excsniper/yasbc/resources/appnotes/iMX6-DDR3-Length-Matching.jpg

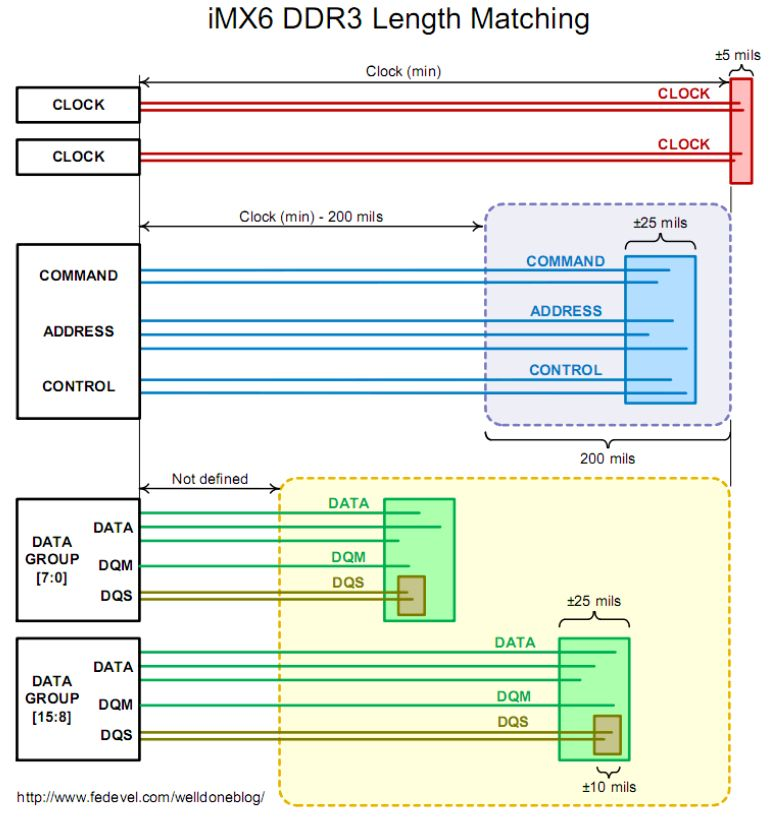
resources/appnotes/iMX6-DDR3-Length-Matching.jpg
