excsniper/yasbc/resources/datasheets/MT3540_Suggested_Layout.PNG

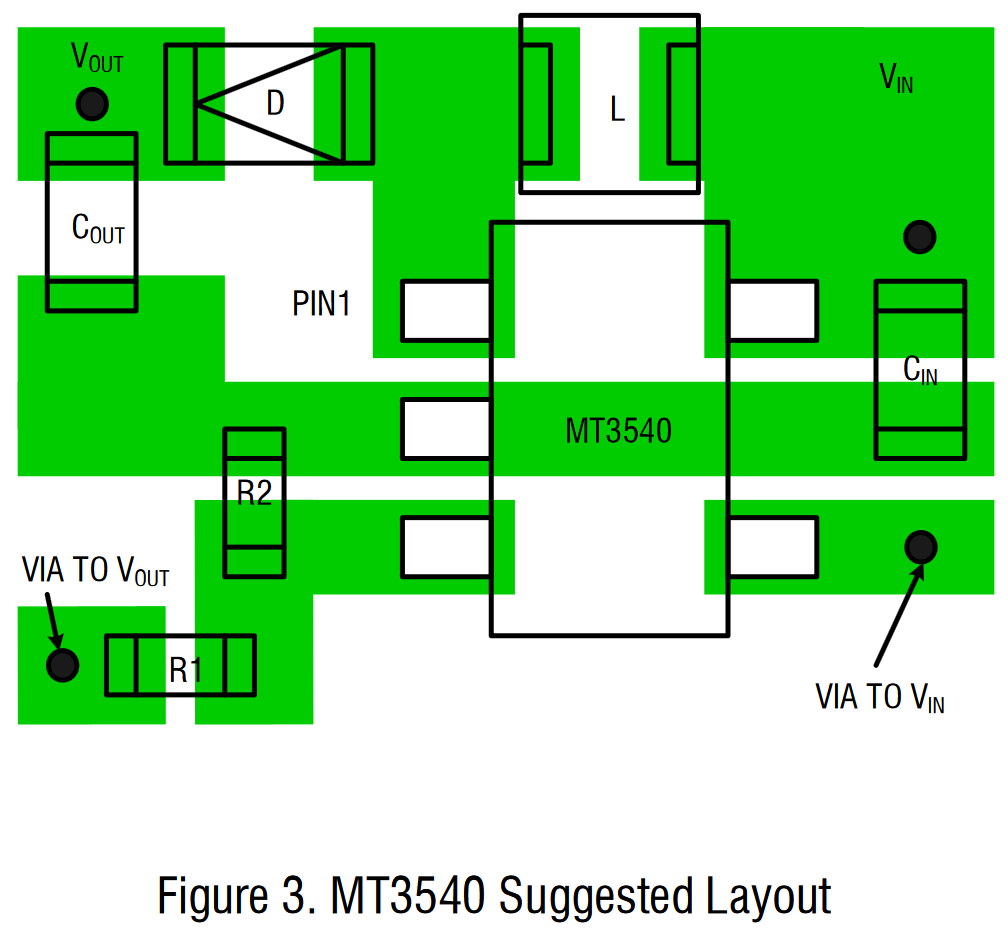
resources/datasheets/MT3540_Suggested_Layout.PNG
