excsniper/yasbc/resources/datasheets/USB_A.jpg

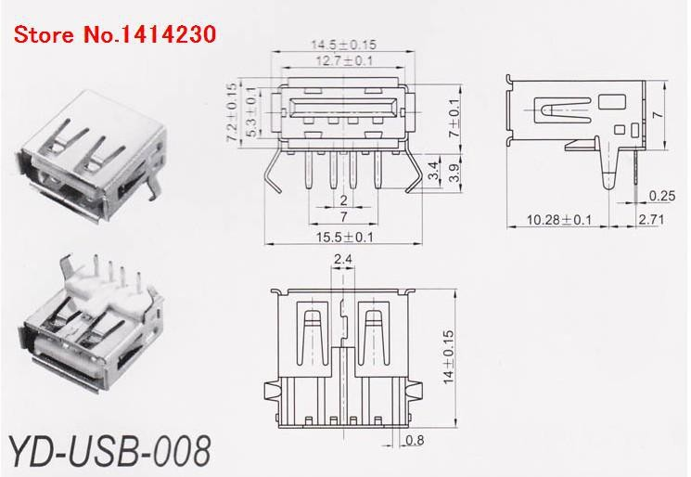
resources/datasheets/USB_A.jpg
