excsniper/yasbc/resources/datasheets/USB_C.png

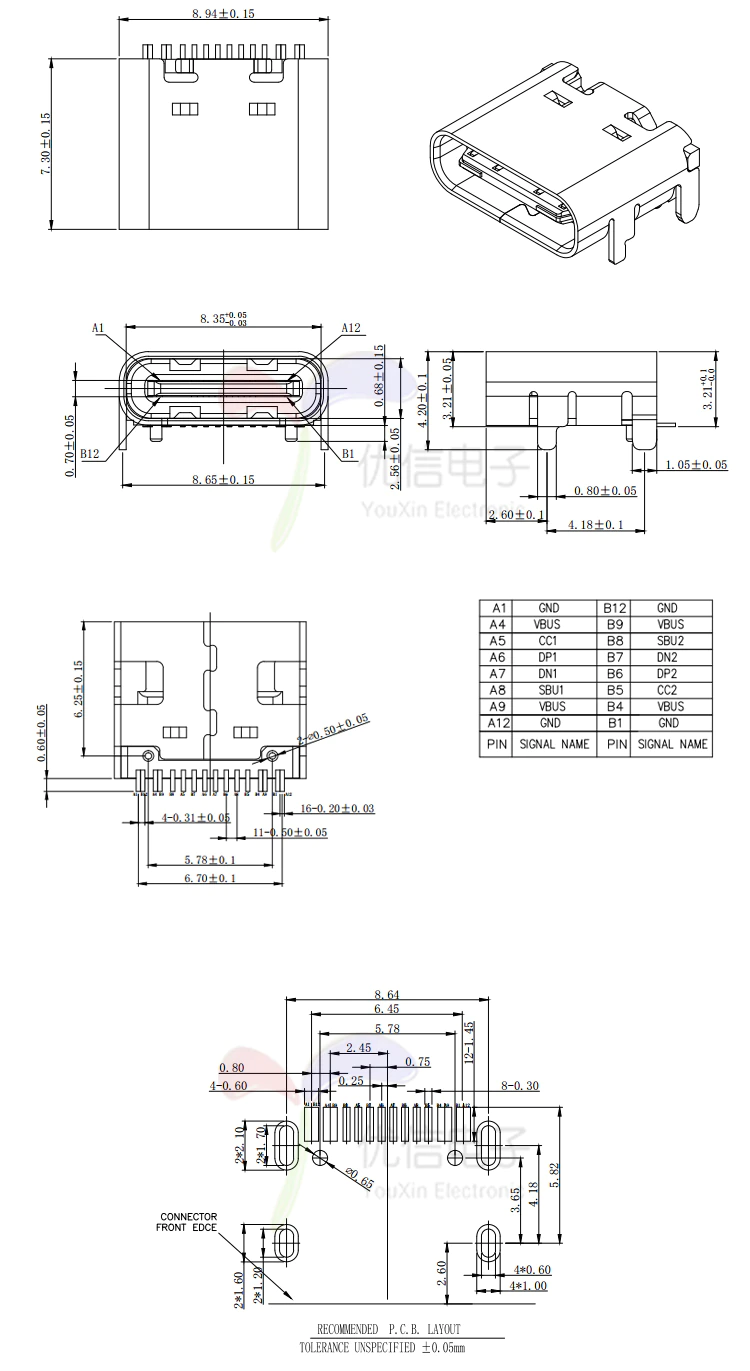
resources/datasheets/USB_C.png
