excsniper/yasbc/pcb/yasbc.kicad_pcb

## KiCad design pcb/yasbc.kicad_pcb (2023-08-11)

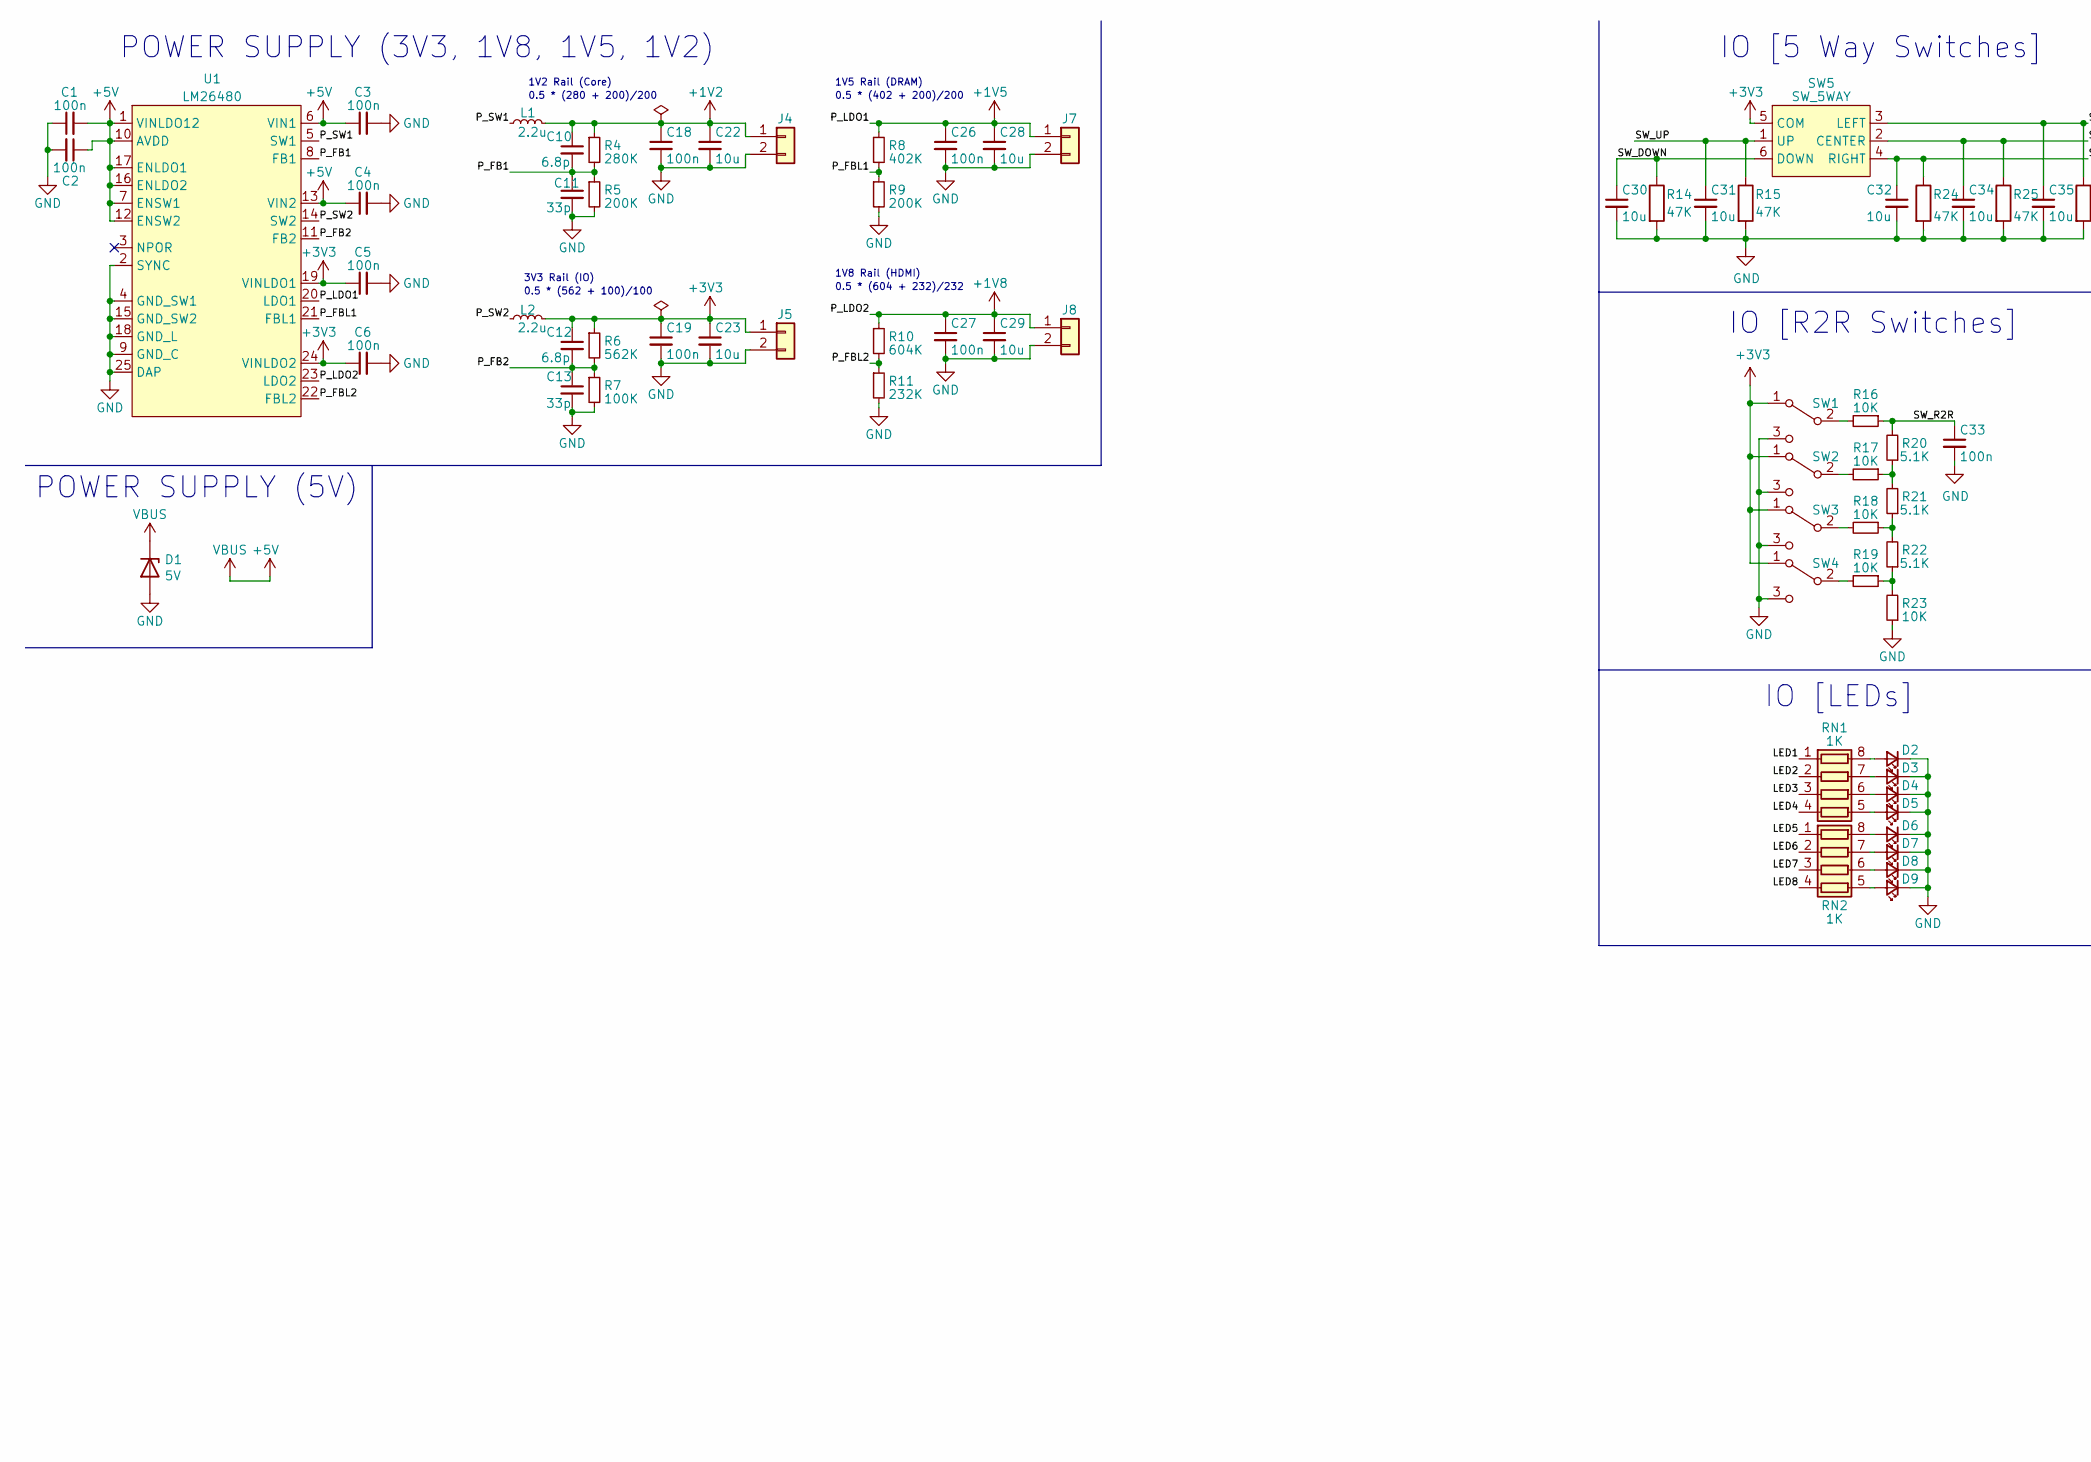
[picture p5: schematic yasbc.kicad_sch, part in row 1, column 1]

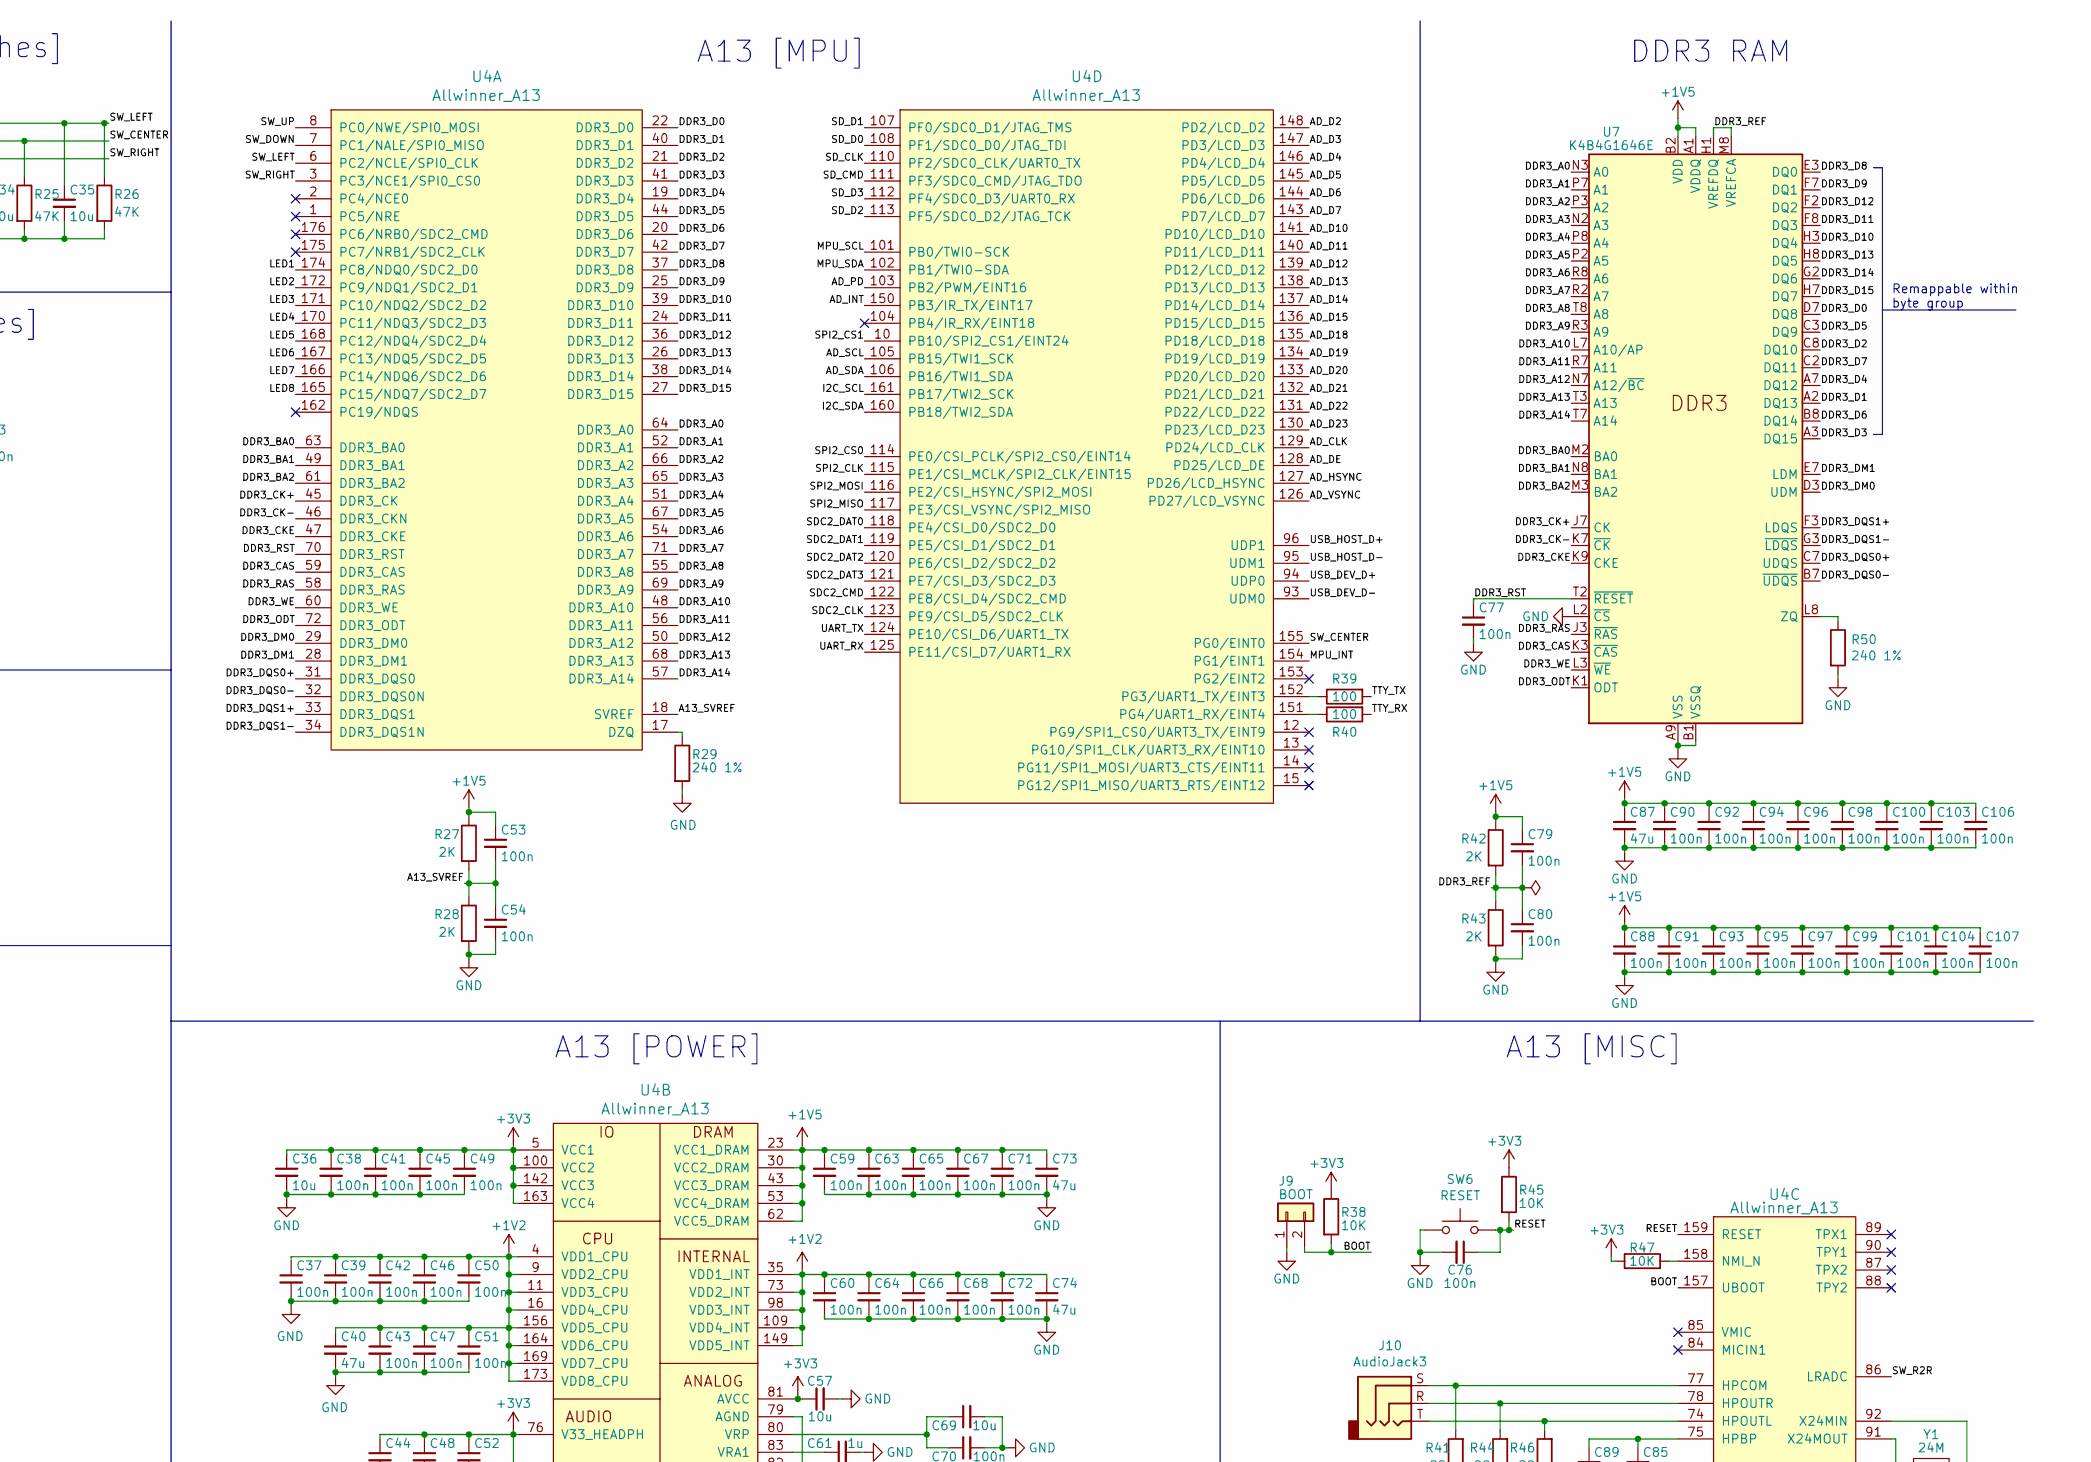
[picture p6: schematic yasbc.kicad_sch, part in row 1, column 2]

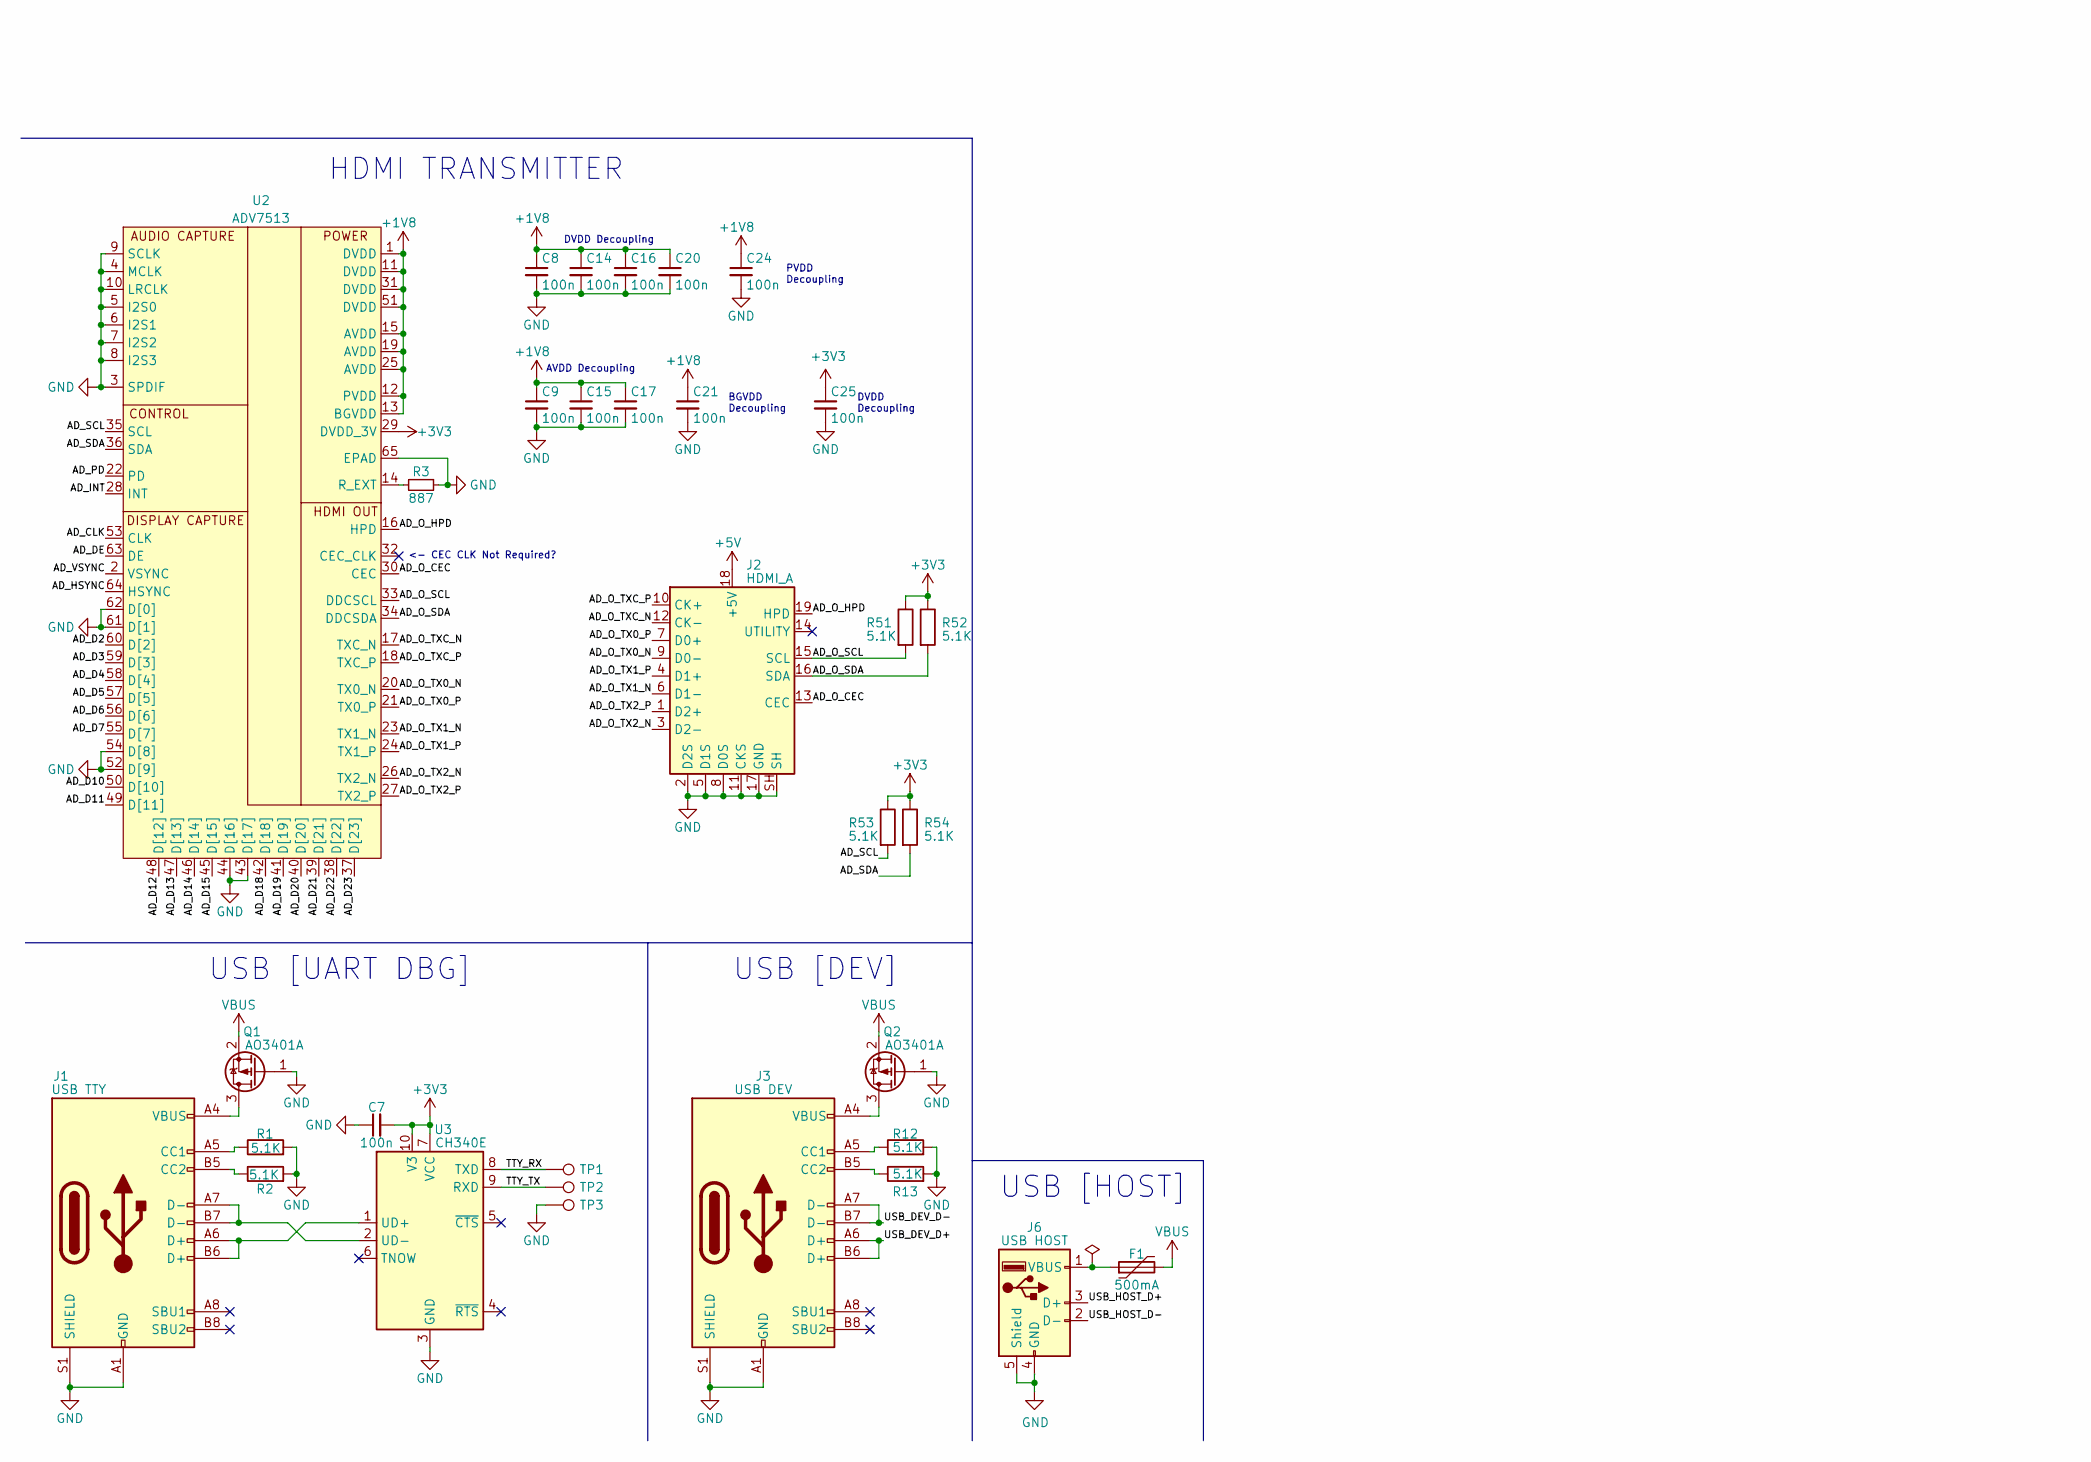
[picture p7: schematic yasbc.kicad_sch, part in row 2, column 1]

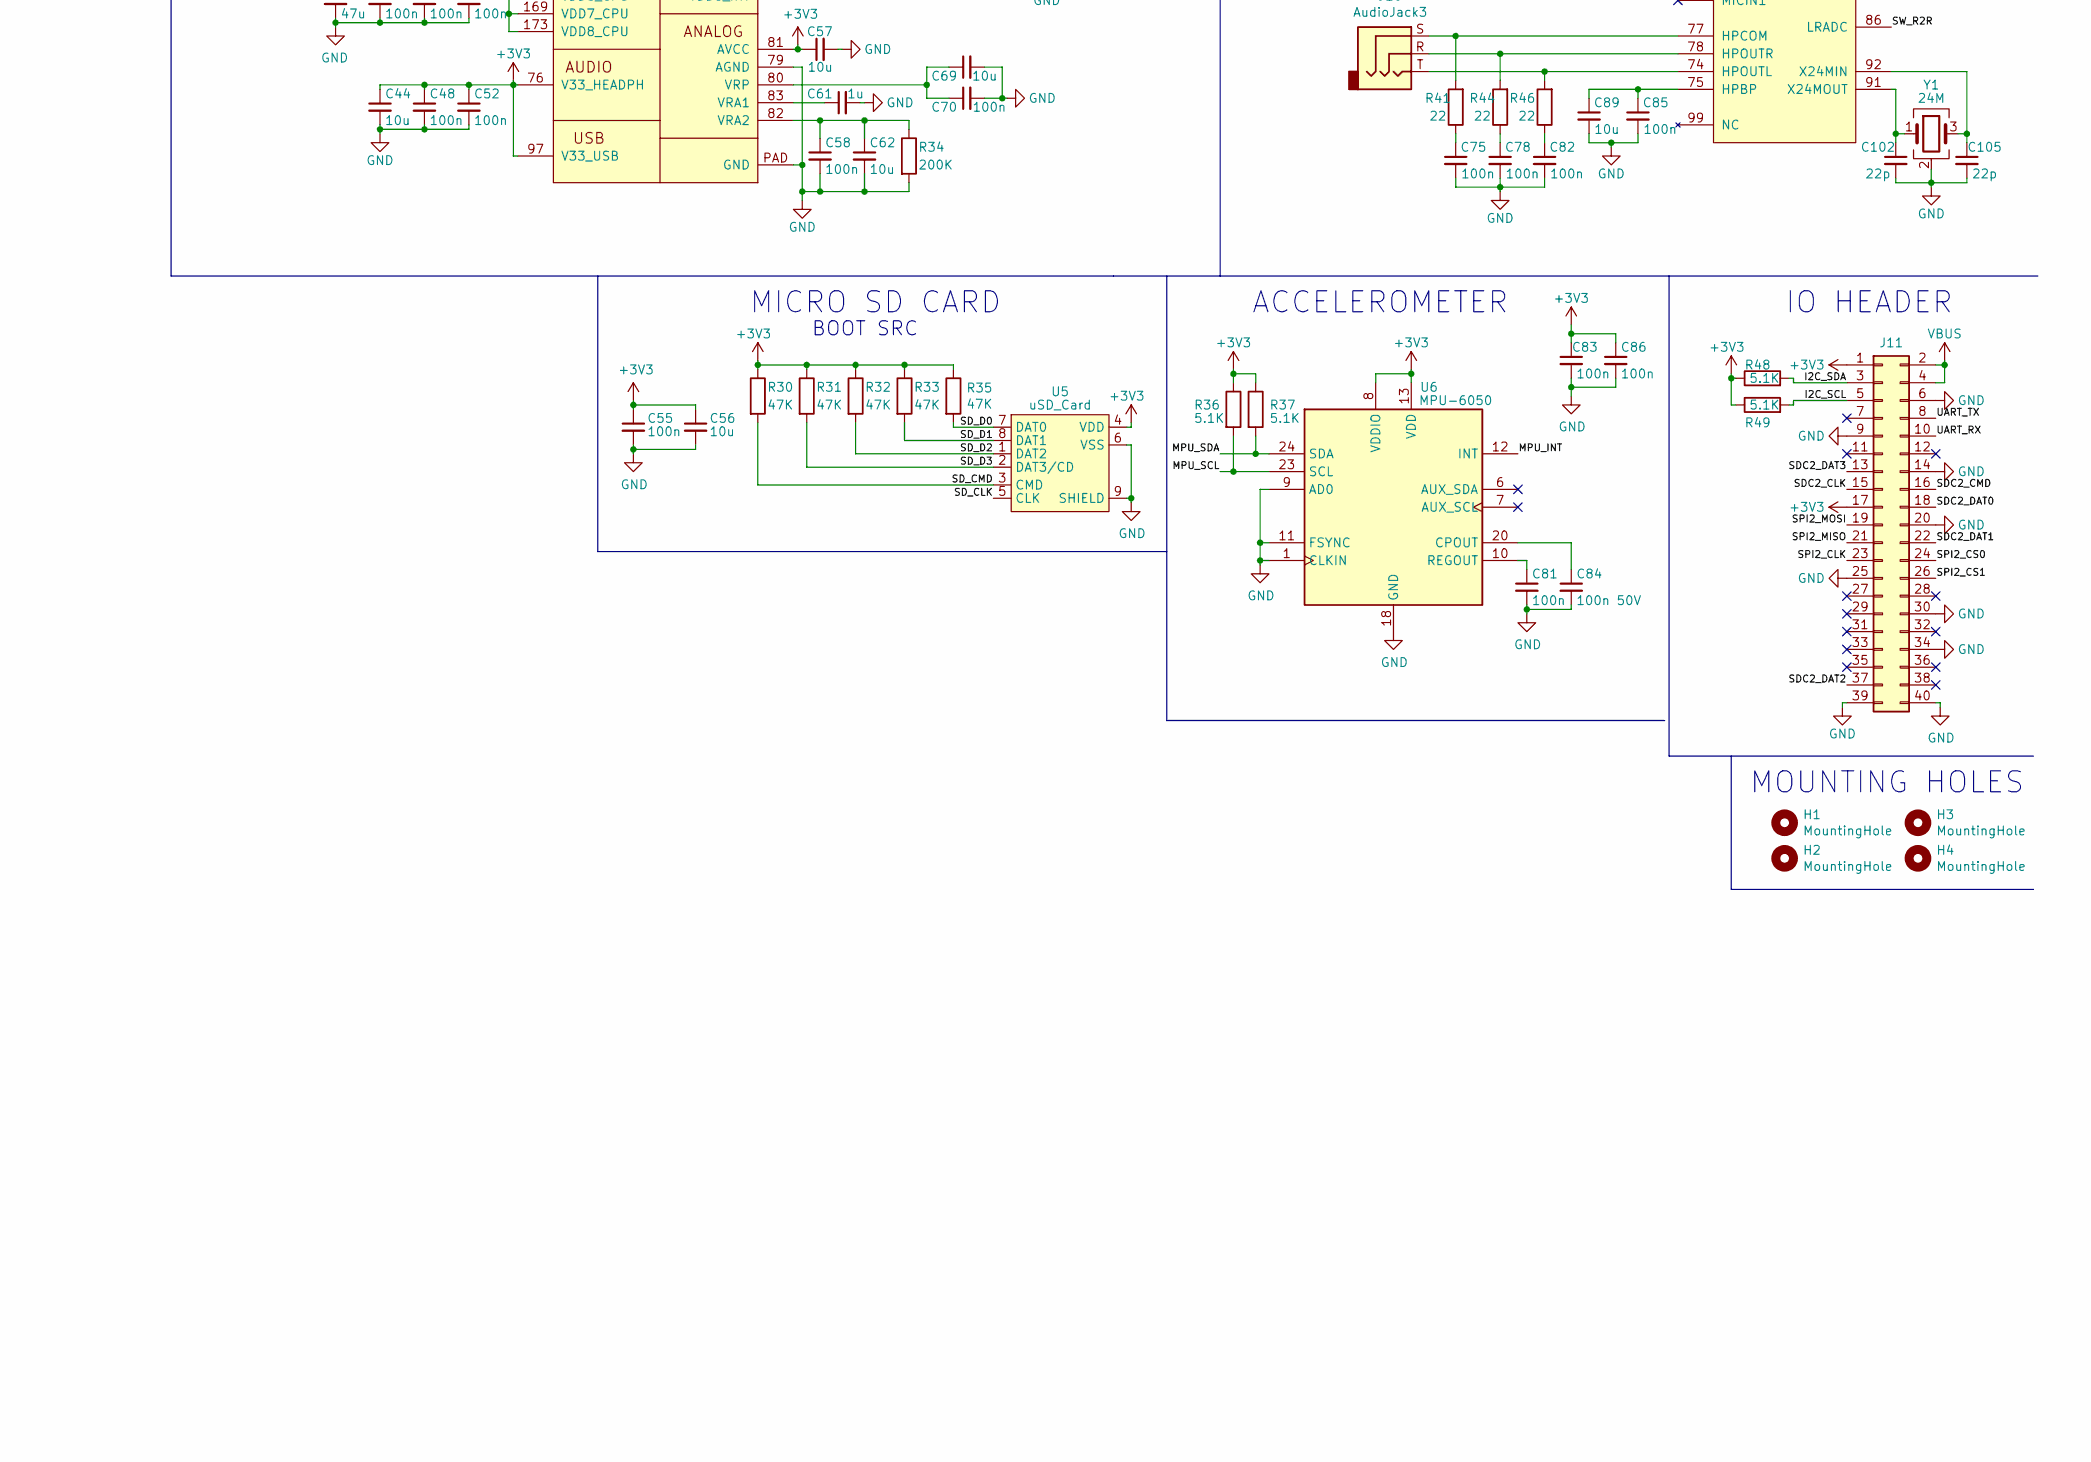
[picture p8: schematic yasbc.kicad_sch, part in row 2, column 2]

Parts:
C1, C2, C3, C4, C5, C6, C7, C8, C9, C14, C15, C16, C17, C18, C19, C20, C21, C24, C25, C26, C27, C33, C37, C38, C39, C41, C42, C43, C45, C46, C47, C48, C49, C50, C51, C52, C53, C54, C55, C58, C59, C60, C63, C64, C65, C66, C67, C68, C70, C71, C72, C75, C76, C77, C78, C79, C80, C81, C82, C83, C85, C86, C88, C90, C91, C92, C93, C94, C95, C96, C97, C98, C99, C100, C101, C103, C104, C106, C107: 100n; C_0402_1005Metric
C10, C12: 6.8p; C_0402_1005Metric
C11, C13: 33p; C_0402_1005Metric
C22, C23, C28, C29, C30, C31, C32, C34, C35, C36, C44, C56, C57, C62, C69, C89: 10u; C_0402_1005Metric
C40, C73, C74, C87: 47u; C_0603_1608Metric
C61: 1u; C_0402_1005Metric
C84: 100n 50V; C_0402_1005Metric
C102, C105: 22p; C_0603_1608Metric
D1: 5V; D_SMB
D2, D3, D4, D5, D6, D7, D8, D9: LED_Small; LED_0603_1608Metric
F1: 500mA; Fuse_0805_2012Metric_Pad1.15x1.40mm_HandSolder
H1, H2, H3, H4: MountingHole; MountingHole_3.2mm_M3
J1: USB TTY; USB_C_Receptacle_HRO_TYPE-C-31-M-12
J2: HDMI_A; HDMI_A_Molex_208658-1001_Horizontal
J3: USB DEV; USB_C_Receptacle_HRO_TYPE-C-31-M-12
J4, J5, J7, J8: 1V5; PinHeader_1x02_P2.54mm_Vertical
J6: USB HOST; USB_A_CONNFLY_DS1095-WNR0
J9: BOOT; PinHeader_1x02_P2.54mm_Vertical
J10: AudioJack3; AudioJack
J11: Conn_02x20_Odd_Even; PinHeader_2x20_P2.54mm_Vertical
L1, L2: 2.2u; Inductor_5.2x5.8x4.5mm
Q1, Q2: AO3401A; SOT-23
R1, R2, R12, R13, R20, R21, R22, R36, R37, R48, R49, R51, R52, R53, R54: 5.1K; R_0603_1608Metric
R3: 887; R_0603_1608Metric
R4: 280K; R_0603_1608Metric
R5, R9, R34: 200K; R_0603_1608Metric
R6: 562K; R_0603_1608Metric
R7: 100K; R_0603_1608Metric
R8: 402K; R_0603_1608Metric
R10: 604K; R_0603_1608Metric
R11: 232K; R_0603_1608Metric
R14, R15, R24, R25, R26, R30, R31, R32, R33, R35: 47K; R_0603_1608Metric
R16, R17, R18, R19, R23, R38, R45, R47: 10K; R_0603_1608Metric
R27, R28, R42, R43: 2K; R_0603_1608Metric
R29, R50: 240 1%; R_0603_1608Metric
R39, R40: 100; R_0603_1608Metric
R41, R44, R46: 22; R_0603_1608Metric
RN1, RN2: 1K; R_Array_Convex_4x0603
SW1, SW2, SW3, SW4: SW_SPDT; SS-12D10
SW5: SW_5WAY; Switches_ALPS-SKRHAAE010
SW6: RESET; HYP-1TS002B-2500-4300-CT
TP1: TX; TestPoint_Pad_D2.0mm
TP2: RX; TestPoint_Pad_D2.0mm
TP3: GND; TestPoint_Pad_D2.0mm
U1: LM26480; WQFN-24-1EP_4x4mm_P0.5mm_EP2.6x2.6mm
U2: ADV7513; LQFP-64-1EP_10x10mm_P0.5mm_EP5x5mm
U3: CH340E; MSOP-10_3x3mm_P0.5mm
U4: Allwinner_A13; LQFP-176_20x20mm_P0.4mm_PAD
U5: uSD_Card; microSD
U6: MPU-6050; InvenSense_QFN-24_4x4mm_P0.5mm
U7: K4B4G1646E; BGA-96_9.0x13.0mm_Layout2x3x16_P0.8mm
Y1: 24M; Crystal_SMD_2016-4Pin_2.0x1.6mm

Connections:
+1V2: C10.1, C18.1, C22.1, C37.1, C39.1, C40.1, C42.1, C43.1, C46.1, C47.1, C50.1, C51.1, C60.1, C64.1, C66.1, C68.1, C72.1, C74.1, J4.1, L1.2, R4.1, U4.4 (VDD1_CPU), U4.9 (VDD2_CPU), U4.11 (VDD3_CPU), U4.16 (VDD4_CPU), U4.35 (VDD1_INT), U4.73 (VDD2_INT), U4.98 (VDD3_INT), U4.109 (VDD4_INT), U4.149 (VDD5_INT), U4.156 (VDD5_CPU), U4.164 (VDD6_CPU), U4.169 (VDD7_CPU), U4.173 (VDD8_CPU)
+1V5: C26.1, C28.1, C53.1, C59.1, C63.1, C65.1, C67.1, C71.1, C73.1, C79.1, C87.1, C88.1, C90.1, C91.1, C92.1, C93.1, C94.1, C95.1, C96.1, C97.1, C98.1, C99.1, C100.1, C101.1, C103.1, C104.1, C106.1, C107.1, J7.1, R8.1, R27.1, R42.1, U1.20 (LDO1), U4.23 (VCC1_DRAM), U4.30 (VCC2_DRAM), U4.43 (VCC3_DRAM), U4.53 (VCC4_DRAM), U4.62 (VCC5_DRAM), U7.A1 (VDDQ), U7.A8 (VDDQ), U7.B2 (VDD), U7.C1 (VDDQ), U7.C9 (VDDQ), U7.D2 (VDDQ), U7.D9 (VDD), U7.E9 (VDDQ), U7.F1 (VDDQ), U7.G7 (VDD), U7.H2 (VDDQ), U7.H9 (VDDQ), U7.K2 (VDD), U7.K8 (VDD), U7.N1 (VDD), U7.N9 (VDD), U7.R1 (VDD), U7.R9 (VDD)
+1V8: C8.1, C9.1, C14.1, C15.1, C16.1, C17.1, C20.1, C21.1, C24.1, C27.1, C29.1, J8.1, R10.1, U1.23 (LDO2), U2.1 (DVDD), U2.11 (DVDD), U2.12 (PVDD), U2.13 (BGVDD), U2.15 (AVDD), U2.19 (AVDD), U2.25 (AVDD), U2.31 (DVDD), U2.51 (DVDD)
+3V3: C5.1, C6.1, C7.2, C12.1, C19.1, C23.1, C25.1, C36.1, C38.1, C41.1, C44.1, C45.1, C48.1, C49.1, C52.1, C55.1, C56.1, C57.1, C83.1, C86.1, J5.1, J11.1, J11.17, L2.2, R6.1, R30.1, R31.1, R32.1, R33.1, R35.1, R36.1, R37.1, R38.1, R45.1, R47.1, R48.1, R49.1, R51.1, R52.1, R53.1, R54.1, SW1.1 (A), SW2.1 (A), SW3.1 (A), SW4.1 (A), SW5.5 (COM), U1.19 (VINLDO1), U1.24 (VINLDO2), U2.29 (DVDD_3V), U3.7 (VCC), U3.10 (V3), U4.5 (VCC1), U4.76 (V33_HEADPH), U4.81 (AVCC), U4.97 (V33_USB), U4.100 (VCC2), U4.142 (VCC3), U4.163 (VCC4), U5.4 (VDD), U6.8 (VDDIO), U6.13 (VDD)
+5V: C1.2, C2.1, C3.1, C4.1, D1.1 (K), F1.2, J2.18 (+5V), J11.2, J11.4, Q1.2 (S), Q2.2 (S), U1.1 (VINLDO12), U1.6 (VIN1), U1.7 (ENSW1), U1.10 (AVDD), U1.12 (ENSW2), U1.13 (VIN2), U1.16 (ENLDO2), U1.17 (ENLDO1)
/A13_SVREF: C53.2, C54.1, R27.2, R28.1, U4.18 (SVREF)
/AD_CLK: U2.53 (CLK), U4.129 (PD24/LCD_CLK)
/AD_D2: U2.60 (D[2]), U4.148 (PD2/LCD_D2)
/AD_D3: U2.59 (D[3]), U4.147 (PD3/LCD_D3)
/AD_D4: U2.58 (D[4]), U4.146 (PD4/LCD_D4)
/AD_D5: U2.57 (D[5]), U4.145 (PD5/LCD_D5)
/AD_D6: U2.56 (D[6]), U4.144 (PD6/LCD_D6)
/AD_D7: U2.55 (D[7]), U4.143 (PD7/LCD_D7)
/AD_D10: U2.50 (D[10]), U4.141 (PD10/LCD_D10)
/AD_D11: U2.49 (D[11]), U4.140 (PD11/LCD_D11)
/AD_D12: U2.48 (D[12]), U4.139 (PD12/LCD_D12)
/AD_D13: U2.47 (D[13]), U4.138 (PD13/LCD_D13)
/AD_D14: U2.46 (D[14]), U4.137 (PD14/LCD_D14)
/AD_D15: U2.45 (D[15]), U4.136 (PD15/LCD_D15)
/AD_D18: U2.42 (D[18]), U4.135 (PD18/LCD_D18)
/AD_D19: U2.41 (D[19]), U4.134 (PD19/LCD_D19)
/AD_D20: U2.40 (D[20]), U4.133 (PD20/LCD_D20)
/AD_D21: U2.39 (D[21]), U4.132 (PD21/LCD_D21)
/AD_D22: U2.38 (D[22]), U4.131 (PD22/LCD_D22)
/AD_D23: U2.37 (D[23]), U4.130 (PD23/LCD_D23)
/AD_DE: U2.63 (DE), U4.128 (PD25/LCD_DE)
/AD_HSYNC: U2.64 (HSYNC), U4.127 (PD26/LCD_HSYNC)
/AD_INT: U2.28 (INT), U4.150 (PB3/IR_TX/EINT17)
/AD_O_CEC: J2.13 (CEC), U2.30 (CEC)
/AD_O_HPD: J2.19 (HPD), U2.16 (HPD)
/AD_O_SCL: J2.15 (SCL), R51.2, U2.33 (DDCSCL)
/AD_O_SDA: J2.16 (SDA), R52.2, U2.34 (DDCSDA)
/AD_O_TX0_N: J2.9 (D0-), U2.20 (TX0_N)
/AD_O_TX0_P: J2.7 (D0+), U2.21 (TX0_P)
/AD_O_TX1_N: J2.6 (D1-), U2.23 (TX1_N)
/AD_O_TX1_P: J2.4 (D1+), U2.24 (TX1_P)
/AD_O_TX2_N: J2.3 (D2-), U2.26 (TX2_N)
/AD_O_TX2_P: J2.1 (D2+), U2.27 (TX2_P)
/AD_O_TXC_N: J2.12 (CK-), U2.17 (TXC_N)
/AD_O_TXC_P: J2.10 (CK+), U2.18 (TXC_P)
/AD_PD: U2.22 (PD), U4.103 (PB2/PWM/EINT16)
/AD_SCL: R53.2, U2.35 (SCL), U4.105 (PB15/TWI1_SCK)
/AD_SDA: R54.2, U2.36 (SDA), U4.106 (PB16/TWI1_SDA)
/AD_VSYNC: U2.2 (VSYNC), U4.126 (PD27/LCD_VSYNC)
/BOOT: J9.2, R38.2, U4.157 (UBOOT)
/DDR3_A0: U4.64 (DDR3_A0), U7.N3 (A0)
/DDR3_A1: U4.52 (DDR3_A1), U7.P7 (A1)
/DDR3_A2: U4.66 (DDR3_A2), U7.P3 (A2)
/DDR3_A3: U4.65 (DDR3_A3), U7.N2 (A3)
/DDR3_A4: U4.51 (DDR3_A4), U7.P8 (A4)
/DDR3_A5: U4.67 (DDR3_A5), U7.P2 (A5)
/DDR3_A6: U4.54 (DDR3_A6), U7.R8 (A6)
/DDR3_A7: U4.71 (DDR3_A7), U7.R2 (A7)
/DDR3_A8: U4.55 (DDR3_A8), U7.T8 (A8)
/DDR3_A9: U4.69 (DDR3_A9), U7.R3 (A9)
/DDR3_A10: U4.48 (DDR3_A10), U7.L7 (A10/AP)
/DDR3_A11: U4.56 (DDR3_A11), U7.R7 (A11)
/DDR3_A12: U4.50 (DDR3_A12), U7.N7 (A12/~BC)
/DDR3_A13: U4.68 (DDR3_A13), U7.T3 (A13)
/DDR3_A14: U4.57 (DDR3_A14), U7.T7 (A14)
/DDR3_BA0: U4.63 (DDR3_BA0), U7.M2 (BA0)
/DDR3_BA1: U4.49 (DDR3_BA1), U7.N8 (BA1)
/DDR3_BA2: U4.61 (DDR3_BA2), U7.M3 (BA2)
/DDR3_CAS: U4.59 (DDR3_CAS), U7.K3 (~CAS)
/DDR3_CK+: U4.45 (DDR3_CK), U7.J7 (CK)
/DDR3_CK-: U4.46 (DDR3_CKN), U7.K7 (~CK)
/DDR3_CKE: U4.47 (DDR3_CKE), U7.K9 (CKE)
/DDR3_D0: U4.22 (DDR3_D0), U7.D7 (DQ8)
/DDR3_D1: U4.40 (DDR3_D1), U7.A2 (DQ13)
/DDR3_D2: U4.21 (DDR3_D2), U7.C8 (DQ10)
/DDR3_D3: U4.41 (DDR3_D3), U7.A3 (DQ15)
/DDR3_D4: U4.19 (DDR3_D4), U7.A7 (DQ12)
/DDR3_D5: U4.44 (DDR3_D5), U7.C3 (DQ9)
/DDR3_D6: U4.20 (DDR3_D6), U7.B8 (DQ14)
/DDR3_D7: U4.42 (DDR3_D7), U7.C2 (DQ11)
/DDR3_D8: U4.37 (DDR3_D8), U7.E3 (DQ0)
/DDR3_D9: U4.25 (DDR3_D9), U7.F7 (DQ1)
/DDR3_D10: U4.39 (DDR3_D10), U7.H3 (DQ4)
/DDR3_D11: U4.24 (DDR3_D11), U7.F8 (DQ3)
/DDR3_D12: U4.36 (DDR3_D12), U7.F2 (DQ2)
/DDR3_D13: U4.26 (DDR3_D13), U7.H8 (DQ5)
/DDR3_D14: U4.38 (DDR3_D14), U7.G2 (DQ6)
/DDR3_D15: U4.27 (DDR3_D15), U7.H7 (DQ7)
/DDR3_DM0: U4.29 (DDR3_DM0), U7.D3 (UDM)
/DDR3_DM1: U4.28 (DDR3_DM1), U7.E7 (LDM)
/DDR3_DQS0+: U4.31 (DDR3_DQS0), U7.C7 (UDQS)
/DDR3_DQS0-: U4.32 (DDR3_DQS0N), U7.B7 (~UDQS)
/DDR3_DQS1+: U4.33 (DDR3_DQS1), U7.F3 (LDQS)
/DDR3_DQS1-: U4.34 (DDR3_DQS1N), U7.G3 (~LDQS)
/DDR3_ODT: U4.72 (DDR3_ODT), U7.K1 (ODT)
/DDR3_RAS: U4.58 (DDR3_RAS), U7.J3 (~RAS)
/DDR3_REF: C79.2, C80.1, R42.2, R43.1, U7.H1 (VREFDQ), U7.M8 (VREFCA)
/DDR3_RST: C77.1, U4.70 (DDR3_RST), U7.T2 (~RESET)
/DDR3_WE: U4.60 (DDR3_WE), U7.L3 (~WE)
/I2C_SCL: J11.5, R49.2, U4.161 (PB17/TWI2_SCK)
/I2C_SDA: J11.3, R48.2, U4.160 (PB18/TWI2_SDA)
/LED1: RN1.1 (R1.1), U4.174 (PC8/NDQ0/SDC2_D0)
/LED2: RN1.2 (R2.1), U4.172 (PC9/NDQ1/SDC2_D1)
/LED3: RN1.3 (R3.1), U4.171 (PC10/NDQ2/SDC2_D2)
/LED4: RN1.4 (R4.1), U4.170 (PC11/NDQ3/SDC2_D3)
/LED5: RN2.1 (R1.1), U4.168 (PC12/NDQ4/SDC2_D4)
/LED6: RN2.2 (R2.1), U4.167 (PC13/NDQ5/SDC2_D5)
/LED7: RN2.3 (R3.1), U4.166 (PC14/NDQ6/SDC2_D6)
/LED8: RN2.4 (R4.1), U4.165 (PC15/NDQ7/SDC2_D7)
/MPU_INT: U4.154 (PG1/EINT1), U6.12 (INT)
/MPU_SCL: R36.2, U4.101 (PB0/TWI0-SCK), U6.23 (SCL)
/MPU_SDA: R37.2, U4.102 (PB1/TWI0-SDA), U6.24 (SDA)
/P_FB1: C10.2, C11.1, R4.2, R5.1, U1.8 (FB1)
/P_FB2: C12.2, C13.1, R6.2, R7.1, U1.11 (FB2)
/P_FBL1: R8.2, R9.1, U1.21 (FBL1)
/P_FBL2: R10.2, R11.1, U1.22 (FBL2)
/P_SW1: L1.1, U1.5 (SW1)
/P_SW2: L2.1, U1.14 (SW2)
/RESET: C76.1, R45.2, SW6.2, U4.159 (RESET)
/SDC2_CLK: J11.15, U4.123 (PE9/CSI_D5/SDC2_CLK)
/SDC2_CMD: J11.16, U4.122 (PE8/CSI_D4/SDC2_CMD)
/SDC2_DAT0: J11.18, U4.118 (PE4/CSI_D0/SDC2_D0)
/SDC2_DAT1: J11.22, U4.119 (PE5/CSI_D1/SDC2_D1)
/SDC2_DAT2: J11.37, U4.120 (PE6/CSI_D2/SDC2_D2)
/SDC2_DAT3: J11.13, U4.121 (PE7/CSI_D3/SDC2_D3)
/SD_CLK: U4.110 (PF2/SDC0_CLK/UART0_TX), U5.5 (CLK)
/SD_CMD: R30.2, U4.111 (PF3/SDC0_CMD/JTAG_TDO), U5.3 (CMD)
/SD_D0: R35.2, U4.108 (PF1/SDC0_D0/JTAG_TDI), U5.7 (DAT0)
/SD_D1: R33.2, U4.107 (PF0/SDC0_D1/JTAG_TMS), U5.8 (DAT1)
/SD_D2: R32.2, U4.113 (PF5/SDC0_D2/JTAG_TCK), U5.1 (DAT2)
/SD_D3: R31.2, U4.112 (PF4/SDC0_D3/UART0_RX), U5.2 (DAT3/CD)
/SPI2_CLK: J11.23, U4.115 (PE1/CSI_MCLK/SPI2_CLK/EINT15)
/SPI2_CS0: J11.24, U4.114 (PE0/CSI_PCLK/SPI2_CS0/EINT14)
/SPI2_CS1: J11.26, U4.10 (PB10/SPI2_CS1/EINT24)
/SPI2_MISO: J11.21, U4.117 (PE3/CSI_VSYNC/SPI2_MISO)
/SPI2_MOSI: J11.19, U4.116 (PE2/CSI_HSYNC/SPI2_MOSI)
/SW_CENTER: C34.1, R25.1, SW5.2 (CENTER), U4.155 (PG0/EINT0)
/SW_DOWN: C30.1, R14.1, SW5.6 (DOWN), U4.7 (PC1/NALE/SPI0_MISO)
/SW_LEFT: C35.1, R26.1, SW5.3 (LEFT), U4.6 (PC2/NCLE/SPI0_CLK)
/SW_R2R: C33.1, R16.1, R20.2, U4.86 (LRADC)
/SW_RIGHT: C32.1, R24.1, SW5.4 (RIGHT), U4.3 (PC3/NCE1/SPI0_CS0)
/SW_UP: C31.1, R15.1, SW5.1 (UP), U4.8 (PC0/NWE/SPI0_MOSI)
/TTY_RX: R40.2, TP1.1, U3.8 (TXD)
/TTY_TX: R39.2, TP2.1, U3.9 (RXD)
/UART_RX: J11.10, U4.125 (PE11/CSI_D7/UART1_RX)
/UART_TX: J11.8, U4.124 (PE10/CSI_D6/UART1_TX)
/USB_DEV_D+: J3.A6 (D+), J3.B6 (D+), U4.94 (UDP0)
/USB_DEV_D-: J3.A7 (D-), J3.B7 (D-), U4.93 (UDM0)
/USB_HOST_D+: J6.3 (D+), U4.96 (UDP1)
/USB_HOST_D-: J6.2 (D-), U4.95 (UDM1)
GND: C1.1, C2.2, C3.2, C4.2, C5.2, C6.2, C7.1, C8.2, C9.2, C11.2, C13.2, C14.2, C15.2, C16.2, C17.2, C18.2, C19.2, C20.2, C21.2, C22.2, C23.2, C24.2, C25.2, C26.2, C27.2, C28.2, C29.2, C30.2, C31.2, C32.2, C33.2, C34.2, C35.2, C36.2, C37.2, C38.2, C39.2, C40.2, C41.2, C42.2, C43.2, C44.2, C45.2, C46.2, C47.2, C48.2, C49.2, C50.2, C51.2, C52.2, C54.2, C55.2, C56.2, C57.2, C58.2, C59.2, C60.2, C61.2, C62.2, C63.2, C64.2, C65.2, C66.2, C67.2, C68.2, C69.2, C70.2, C71.2, C72.2, C73.2, C74.2, C75.2, C76.2, C77.2, C78.2, C80.2, C81.2, C82.2, C83.2, C84.2, C85.2, C86.2, C87.2, C88.2, C89.2, C90.2, C91.2, C92.2, C93.2, C94.2, C95.2, C96.2, C97.2, C98.2, C99.2, C100.2, C101.2, C102.2, C103.2, C104.2, C105.2, C106.2, C107.2, D1.2 (A), D2.1 (K), D3.1 (K), D4.1 (K), D5.1 (K), D6.1 (K), D7.1 (K), D8.1 (K), D9.1 (K), J1.A1 (GND), J1.A12 (GND), J1.B1 (GND), J1.B12 (GND), J1.S1 (SHIELD), J2.2 (D2S), J2.5 (D1S), J2.8 (D0S), J2.11 (CKS), J2.17 (GND), J2.SH, J3.A1 (GND), J3.A12 (GND), J3.B1 (GND), J3.B12 (GND), J3.S1 (SHIELD), J4.2, J5.2, J6.4 (GND), J6.5 (Shield), J7.2, J8.2, J9.1, J11.6, J11.9, J11.14, J11.20, J11.25, J11.30, J11.34, J11.39, J11.40, Q1.1 (G), Q2.1 (G), R1.2, R2.2, R3.1, R5.2, R7.2, R9.2, R11.2, R12.2, R13.2, R14.2, R15.2, R23.1, R24.2, R25.2, R26.2, R28.2, R29.2, R34.2, R43.2, R50.2, SW1.3 (C), SW2.3 (C), SW3.3 (C), SW4.3 (C), SW6.1, TP3.1, U1.2 (SYNC), U1.4 (GND_SW1), U1.9 (GND_C), U1.15 (GND_SW2), U1.18 (GND_L), U1.25 (DAP), U2.3 (SPDIF), U2.4 (MCLK), U2.5 (I2S0), U2.6 (I2S1), U2.7 (I2S2), U2.8 (I2S3), U2.9 (SCLK), U2.10 (LRCLK), U2.43 (D[17]), U2.44 (D[16]), U2.52 (D[9]), U2.54 (D[8]), U2.61 (D[1]), U2.62 (D[0]), U2.65 (EPAD), U3.3 (GND), U4.79 (AGND), U4.PAD (GND), U5.6 (VSS), U5.9 (SHIELD), U6.1 (CLKIN), U6.9 (AD0), U6.11 (FSYNC), U6.18 (GND), U7.A9 (VSS), U7.B1 (VSSQ), U7.B3 (VSS), U7.B9 (VSSQ), U7.D1 (VSSQ), U7.D8 (VSSQ), U7.E1 (VSS), U7.E2 (VSSQ), U7.E8 (VSSQ), U7.F9 (VSSQ), U7.G1 (VSSQ), U7.G8 (VSS), U7.G9 (VSSQ), U7.J2 (VSS), U7.J8 (VSS), U7.L2 (~CS), U7.M1 (VSS), U7.M9 (VSS), U7.P1 (VSS), U7.P9 (VSS), U7.T1 (VSS), U7.T9 (VSS), Y1.2, Y1.4
unnamed: C75.1, R41.1
unnamed: C78.1, R44.1
unnamed: C82.1, R46.1
unnamed: D2.2 (A), RN1.8 (R1.2)
unnamed: D3.2 (A), RN1.7 (R2.2)
unnamed: D4.2 (A), RN1.6 (R3.2)
unnamed: D5.2 (A), RN1.5 (R4.2)
unnamed: D6.2 (A), RN2.8 (R1.2)
unnamed: D7.2 (A), RN2.7 (R2.2)
unnamed: D8.2 (A), RN2.6 (R3.2)
unnamed: D9.2 (A), RN2.5 (R4.2)
unnamed: J1.A5 (CC1), R1.1
unnamed: J1.B5 (CC2), R2.1
unnamed: J3.A5 (CC1), R12.1
unnamed: J3.B5 (CC2), R13.1
unnamed: F1.1, J6.1 (VBUS)
unnamed: J1.A4 (VBUS), J1.A9 (VBUS), J1.B4 (VBUS), J1.B9 (VBUS), Q1.3 (D)
unnamed: J3.A4 (VBUS), J3.A9 (VBUS), J3.B4 (VBUS), J3.B9 (VBUS), Q2.3 (D)
unnamed: R17.1, R20.1, R21.2
unnamed: R18.1, R21.1, R22.2
unnamed: R19.1, R22.1, R23.2
unnamed: R16.2, SW1.2 (B)
unnamed: R17.2, SW2.2 (B)
unnamed: R18.2, SW3.2 (B)
unnamed: R19.2, SW4.2 (B)
unnamed: R3.2, U2.14 (R_EXT)
unnamed: J1.A6 (D+), J1.B6 (D+), U3.1 (UD+)
unnamed: J1.A7 (D-), J1.B7 (D-), U3.2 (UD-)
unnamed: R29.1, U4.17 (DZQ)
unnamed: C61.1, U4.83 (VRA1)
unnamed: C58.1, C62.1, R34.1, U4.82 (VRA2)
unnamed: C69.1, C70.1, U4.80 (VRP)
unnamed: C85.1, C89.1, U4.75 (HPBP)
unnamed: J10.S, R41.2, U4.77 (HPCOM)
unnamed: J10.T, R46.2, U4.74 (HPOUTL)
unnamed: J10.R, R44.2, U4.78 (HPOUTR)
unnamed: R47.2, U4.158 (NMI_N)
unnamed: C105.1, U4.92 (X24MIN), Y1.3
unnamed: C102.1, U4.91 (X24MOUT), Y1.1
unnamed: R39.1, U4.152 (PG3/UART1_TX/EINT3)
unnamed: R40.1, U4.151 (PG4/UART1_RX/EINT4)
unnamed: C84.1, U6.20 (CPOUT)
unnamed: C81.1, U6.10 (REGOUT)
unnamed: R50.1, U7.L8 (ZQ)

Notes on the sheet:
A13 [MISC]
USB [HOST]
IO [R2R Switches]
1V5 Rail (DRAM)
DVDD Decoupling
Remappable within byte group
POWER SUPPLY (3V3, 1V8, 1V5, 1V2)
IO [5 Way Switches]
0.5 * (280 + 200)/200
MOUNTING HOLES
0.5 * (604 + 232)/232
USB [UART DBG]
0.5 * (402 + 200)/200
0.5 * (562 + 100)/100
IO [LEDs]
BGVDD Decoupling
PVDD Decoupling
IO HEADER
1V8 Rail (HDMI)
POWER SUPPLY (5V)
<- CEC CLK Not Required?
3V3 Rail (IO)
1V2 Rail (Core)
DDR3 RAM
USB [DEV]
A13 [POWER]
DVDD Decoupling
HDMI TRANSMITTER
A13 [MPU]
AVDD Decoupling
ACCELEROMETER
BOOT SRC
MICRO SD CARD

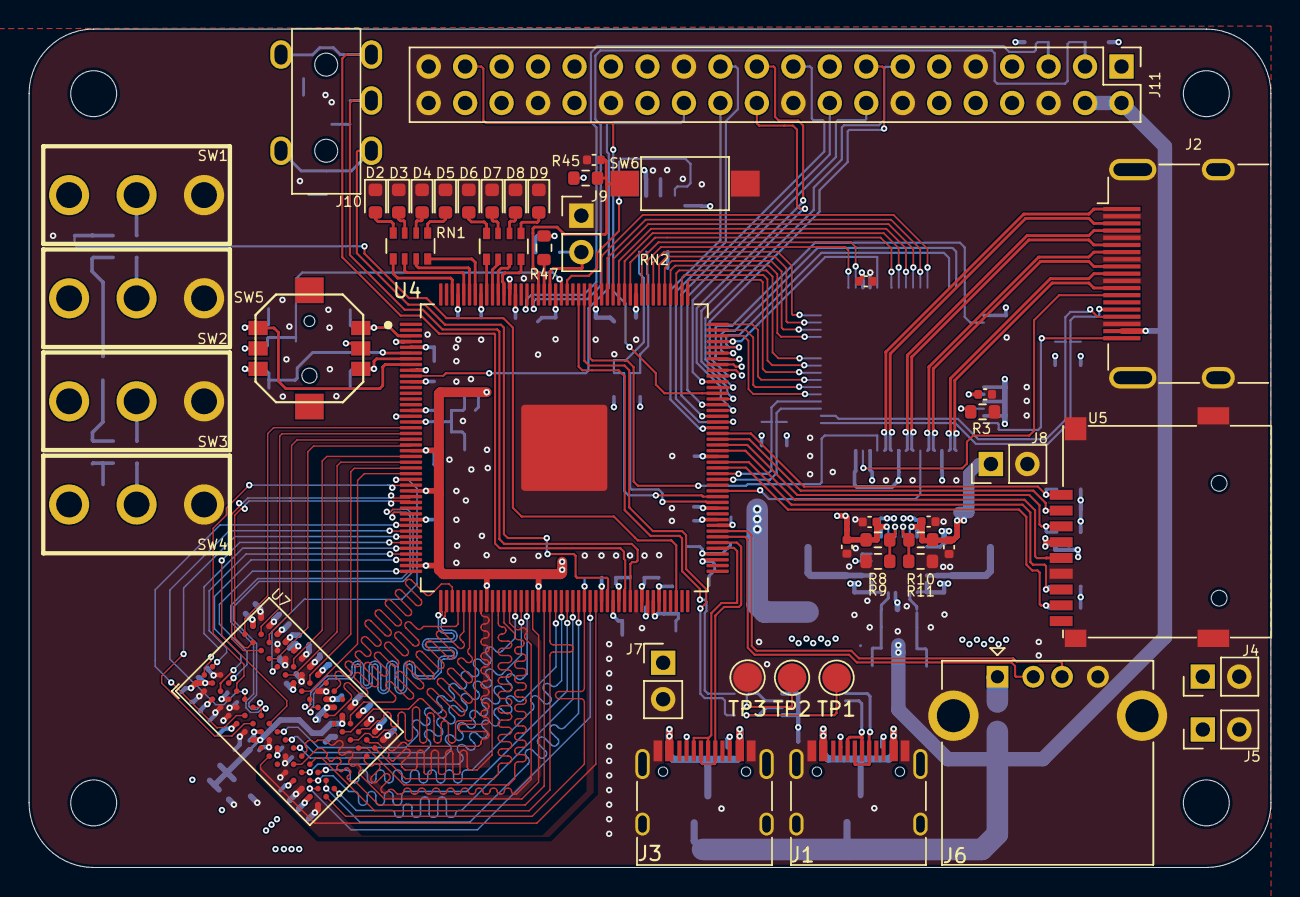
[picture p9: board yasbc.kicad_pcb from above]

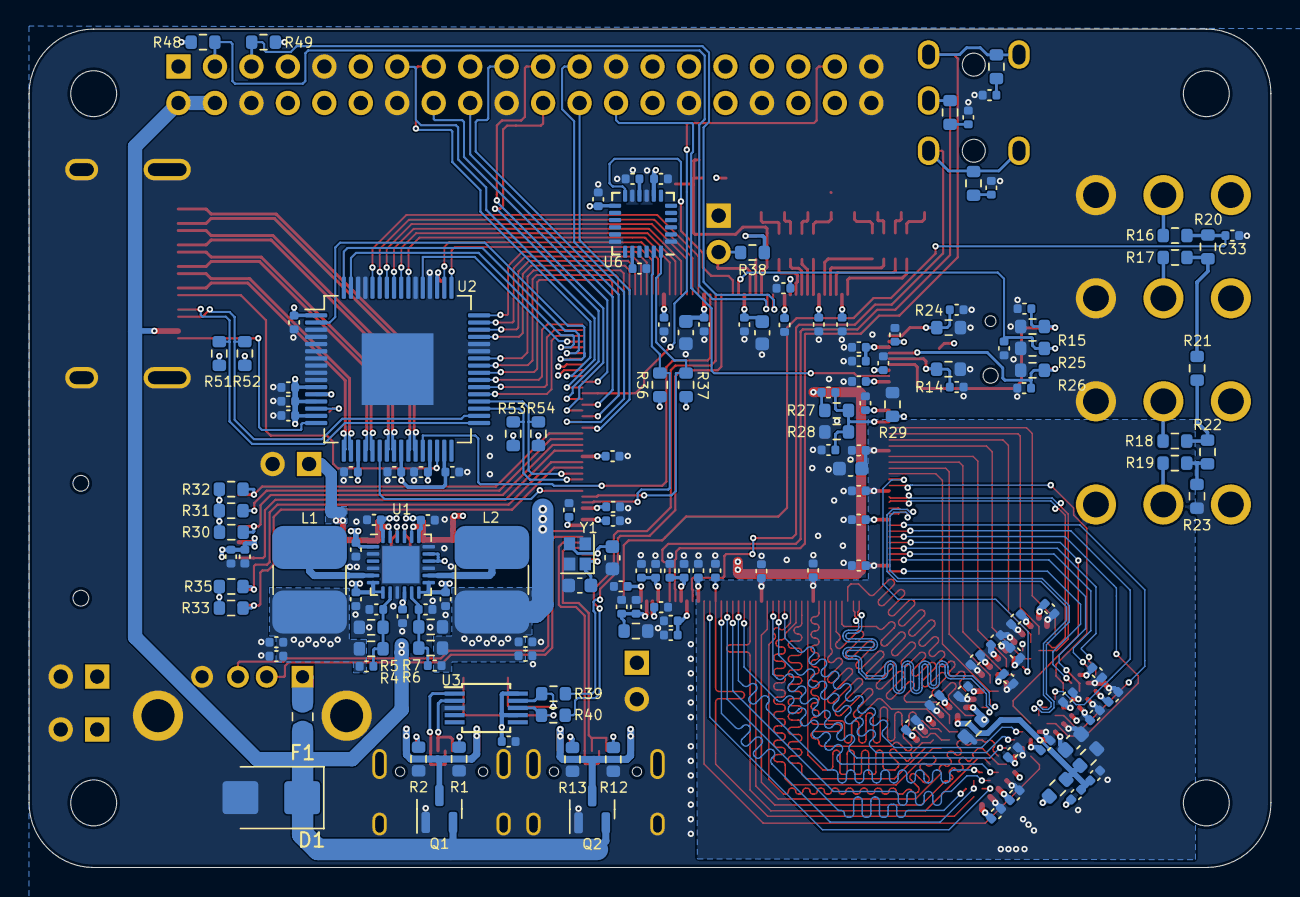
[picture p10: board yasbc.kicad_pcb from below]

Board: 4 copper layers, 86.5 x 58.4 mm, 209 parts (158 on the bottom side), 190 nets.
