excsniper/yasbc/(commit log)

2021-06-15 Added pcb project and A13 symbol
    [yasbc.kicad_pcb, yasbc.sch]
2021-06-15 Added SSD1306 symbol, started sch
    [yasbc.sch]
2021-06-15 Worked on sch
    [yasbc.sch]
2021-06-28 PCB progress
    [yasbc.sch]
2021-07-05 Added power section to schematic
    [yasbc.sch]
2021-07-05 Fixed power section
    [yasbc.sch]
2021-07-05 Minor power fix
    [yasbc.sch]
2021-07-07 Added 5-way SW, sliders and fixed LEDs
    [yasbc.sch]
2021-07-11 Added MPU6050
    [yasbc.sch]
2021-07-12 Minor fixed, initial footprint work
    [yasbc.sch]
2021-07-14 Added series resistors on usb and fixed some ERC errors
    [yasbc.sch]
2021-07-23 Inital footprint work
    [yasbc.sch]
2021-08-04 Worked on sch and footprints
    [yasbc.sch]
2021-08-06 Added cap to DDR_RST
    [yasbc.sch]
2021-10-23 Added SSD1306 footprint
    [yasbc.sch]
2021-10-24 Fixed audiojack footprint
2021-10-24 Added microsd footprint
    [yasbc.sch]
2021-10-24 Started layout
    [yasbc.kicad_pcb, yasbc.sch]
2021-10-28 Added USB connector datasheets and footprints
    [yasbc.kicad_pcb, yasbc.sch]
2021-10-28 Added Reset and 5Way switch datasheets and footprints
    [yasbc.kicad_pcb, yasbc.sch]
2021-10-29 Added SPDT datasheets and footprints
    [yasbc.kicad_pcb, yasbc.sch]
2021-10-31 Worked on layout
    [yasbc.kicad_pcb, yasbc.sch]
2021-11-09 Added boost reg for OLED and new inductors
    [yasbc.kicad_pcb, yasbc.sch]
2021-11-22 Added new OLED, worked on sch & pcb
    [yasbc.kicad_pcb, yasbc.sch]
2021-12-10 Reduced to one +1V5 LDO
    [yasbc.kicad_pcb, yasbc.sch]
2021-12-22 Removed OLED and ESP32
    [yasbc.kicad_pcb, yasbc.sch]
2021-12-27 Converted to kicad 6 and worked on pcb
    [yasbc.kicad_pcb, yasbc.kicad_sch, yasbc.sch]
2021-12-29 Routed DDR3 data signals
    [yasbc.kicad_pcb, yasbc.kicad_sch]
2022-01-02 Routed DDR3 clock, address, command and control signals
    [yasbc.kicad_pcb]
2022-01-04 Worked on DDR3 decoupling caps
    [yasbc.kicad_pcb, yasbc.kicad_sch]
2022-07-03 PCB project folder structure cleanup
    - Moved schematic and footprint libraries into lib folder
2022-07-14 Cleaned up schematic
    [yasbc.kicad_sch]
2022-09-24 Further work on schematic
    [yasbc.kicad_pcb, yasbc.kicad_sch]
2022-10-22 Schematic draft
    [yasbc.kicad_sch]
2022-10-29 PMIC PCB layout
    [yasbc.kicad_pcb, yasbc.kicad_sch]
2023-03-18 Upgrade to Kicad 7
    [yasbc.kicad_sch]
2023-03-18 IO PCB routing progress
    [yasbc.kicad_sch]
2023-08-11 DDR3 clock, address and control routing
    [yasbc.kicad_pcb]
2023-08-13 Finished DDR3 routing and layout
    [yasbc.kicad_sch]
2023-08-13 Added silkscreen labels
    [yasbc.kicad_sch]
2023-08-21 Fixed silkscreen and exported V0.1 gerbers
2023-08-22 Updated silkscreen and regenerated gerber
    [yasbc-B_Cu.gbl, yasbc-B_Mask.gbs, yasbc-B_Paste.gbp, yasbc-B_Silkscreen.gbo, yasbc-Edge_Cuts.gm1, yasbc-F_Cu.gtl, yasbc-F_Mask.gts, yasbc-F_Paste.gtp]
